nitish-kumar-ngh/Analog_Calculator/Analog-Calculator-master/Adder-Subtractor.asc

R1: res; 4.29k
R2: res; 4.29k
R3: res; 4.29k
R4: res; 4.29k
R5: res; 4.29k
R6: res; 4.29k
R7: res; 4.29k
R8: res; 4.29k
R9: res; 4.29k
R10: res; 4.29k
U1: LM741
U2: LM741
U3: LM741
U4: LM741
V1: voltage; 1
V2: voltage; 1
V3: voltage; -12
V4: voltage; 12
V5: voltage; 4
V6: voltage; 3
Named nets: 0, Vcc, Vee
.tran 1ms
Adder
Subtractor
