nitish-kumar-ngh/Analog_Calculator/Analog-Calculator-master/Multiplier.asc

D1: diode; 1N4148
D2: diode; 1N4148
D3: diode; 1N4148
D4: diode; 1N4148
R1: res; 4.32k
R2: res; 4.32k
R3: res; 4.32k
R4: res; 4.32k
R5: res; 4.32k
R6: res; 4.32k
R7: res; 4.32k
R8: res; 4.32k
R9: res; 4.32k
R10: res; 4.32k
R11: res; 4.32k
R12: res; 4.32k
U1: LM741
U2: LM741
U3: LM741
U4: LM741
U5: LM741
U6: LM741
U7: LM741
V1: voltage; 3
V2: voltage; 1
V3: voltage; 15
V4: voltage; 15
V5: voltage; 1
Named nets: 0, Vcc, Vee
.tran 20
