nitish-kumar-ngh/Analog_Calculator/Analog-Calculator-master/Nth Root.asc

D1: diode; 1N4148
D2: diode; 1N4148
D3: diode; 1N4148
Q1: pnp; BC557B
Q3: npn; BC547B
Q4: pnp; BC557B
Q5: pnp; BC557B
Q6: pnp; BC557B
Q16: npn; BC547B
Q17: npn; BC547B
Q22: npn; BC547B
Q23: npn; BC547B
Q24: npn; BC547B
R1: res; 15k
R2: res; 1k
R3: res; 11.2k
R4: res; 1000k
R5: res; 15k
R6: res; 11.2k
R7: res; 11.2k
R8: res; 11.2k
R9: res; 11.2k
R11: res; 11.2k
R12: res; 11.2k
R13: res; 4.32k
R14: res; 4.32k
R15: res; 4.32k
R16: res; 4.32k
R17: res; 4.32k
R35: res; 10.6k
R36: res; 390
R37: res; 1k
R38: res; 1k
R39: res; 1k
R40: res; 37k
R41: res; 37k
R42: res; 1000k
R43: res; 1k
R48: res; 10.6k
R49: res; 390
R50: res; 37k
R51: res; 10.6k
R52: res; 390
R53: res; 10.6k
R54: res; 390
R55: res; 37k
R57: res; 37k
U1: LM741
U2: LM741
U3: LM741
U4: LM741
U5: LM741
U6: LM741
U7: LM741
U8: LM741
U9: LM741
U10: LM741
V1: voltage; 4
V2: voltage; 5
V3: voltage; 12
V4: voltage; 12
V5: voltage; 1
V6: voltage; 8
V7: voltage; 1
V8: voltage; 2
V11: voltage; 10
Named nets: 0, Vcc, Vee, VG4_F, VG1_F, VG5_F, VG3_F, VG6_F, VG2_F, V1, V2, V3
.tran 1ms
Average Unit
Fifth root Ckt
Current Mirror
