nitish-kumar-ngh/Analog_Calculator/Analog-Calculator-master/Scaler-Descaler.asc

R1: res; 12k
R2: res; 2.5k
R3: res; 2.5k
R4: res; 12k
R5: res; 2.5k
R6: res; 12k
R7: res; 12k
R8: res; 2.5k
U1: LM741
U2: LM741
V1: voltage; -12
V2: voltage; 12
V3: voltage; 15
V4: voltage; -15
V5: voltage; 2.5
V6: voltage; 0
Named nets: 0, Vcc, Vee
.tran 1m
+-12 to 0-5 Volts
0-5V to +-12V
